vandemaelefelix/Project-4-Self-driving-car/lane_detection/images/image2.jpg

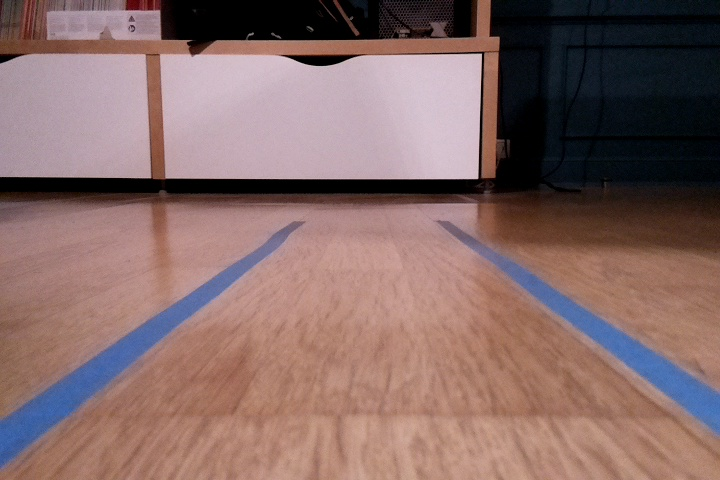
lane_detection/images/image2.jpg
