vandemaelefelix/Project-4-Self-driving-car/documentation/sources.pdf

[1] lanc1999Follow, “DC Motor Control With Raspberry Pi and L293D,” Instructables. [Online]. Available: https://www.instructables.com/id/DC-Motor-Control-With-Raspberry-Pi-and-L293D/. [Accessed: 23-Jan-2020].
[2] D. Tian, “DeepPiCar — Part 1: How to Build a Deep Learning, Self Driving Robotic Car on a Shoestring Budget,” Medium, 08-May-2019. [Online]. Available: https://towardsdatascience.com/deeppicar-part-1-102e03c83f2c. [Accessed: 23-Jan-2020].
[3] D. Tian, “DeepPiCar — Part 2: Pi Setup and PiCar Assembly,” Medium, 13-May-2019. [Online]. Available: https://towardsdatascience.com/deeppicar-part-2-8512be2133f3. [Accessed: 23-Jan-2020].
[4] “DeepPiCar — Part 4: Autonomous Lane Navigation via OpenCV.” [Online]. Available: https://towardsdatascience.com/deeppicar-part-4-lane-following-via-opencv-737dd9e47c96. [Accessed: 23-Jan-2020].
[5] D. Tian, “DeepPiCar — Part 5: Autonomous Lane Navigation via Deep Learning,” Medium, 17-May-2019. [Online]. Available: https://towardsdatascience.com/deeppicar-part-5-lane-following-via-deep-learningd93acdce6110. [Accessed: 23-Jan-2020].
[6] “End-to-End Deep Learning for Self-Driving Cars,” NVIDIA Developer Blog, 18-Aug-2016. [Online]. Available: https://devblogs.nvidia.com/deep-learning-self-driving-cars/. [Accessed: 23-Jan-2020].
[7] “How to write a simple python code to find the intersection point between two straight lines ?” [Online]. Available: https://www.science-emergence.com/Articles/How-to-write-a-simple-python-code-to-find-theintersection-point-between-two-straight-lines-/. [Accessed: 23-Jan-2020].
[8] H. S. Chadha, “Predicting Steering Angles using Deep Learning: Behaviour Cloning,” Medium, 19-Nov-2019. [Online]. Available: https://becominghuman.ai/behavioral-cloning-in-deep-learning-using-keras-3786f5914b72. [Accessed: 23-Jan-2020].
[9] “Raspberry Pi: Reading an analog potentiometer with the A/D converter MCP3008 and SPI | Knight of Pi.”
[Online]. Available: http://www.knight-of-pi.org/reading-an-analog-potentiometer-with-the-ad-convertermcp3008-and-spi/. [Accessed: 23-Jan-2020].
[10] S. Du, H. Guo, and A. Simpson, “Self-Driving Car Steering Angle Prediction Based on Image Recognition,” p. 9.
[11] “Teaching Cars To Drive Using Deep Learning — Steering Angle Prediction.” [Online]. Available: https://towardsdatascience.com/teaching-cars-to-drive-using-deep-learning-steering-angle-prediction-5773154608f2. [Accessed: 23-Jan-2020].
