vandemaelefelix/Project-4-Self-driving-car/documentation/schematics/scheme_servo_dc.png

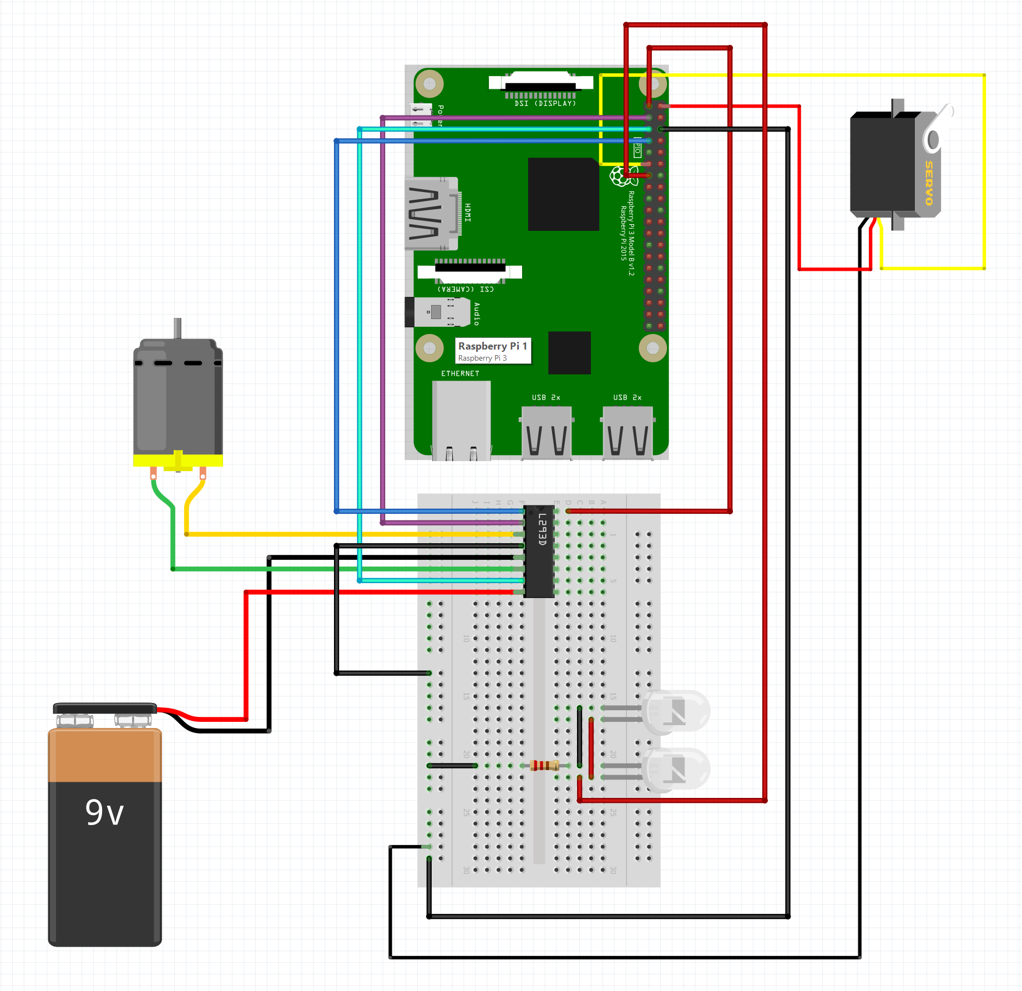
documentation/schematics/scheme_servo_dc.png
