vandemaelefelix/Project-4-Self-driving-car/documentation/schematics/scheme_servo_dc_pot.png

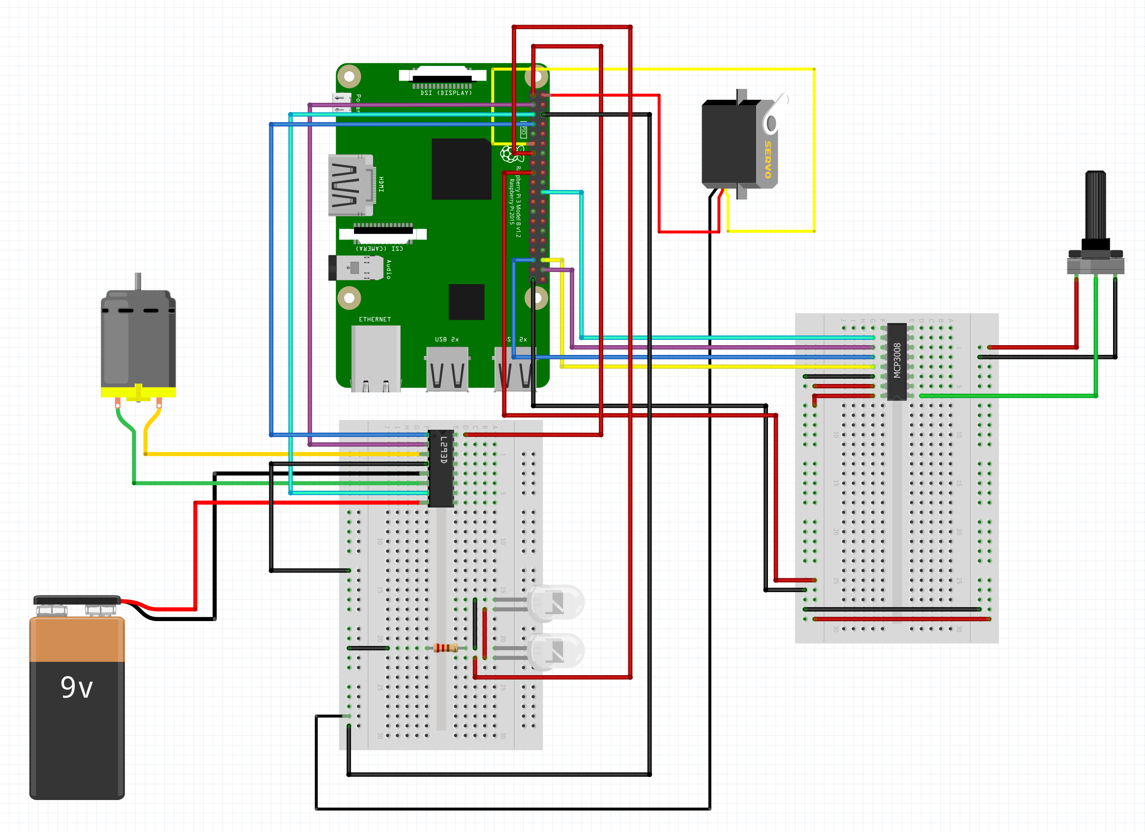
documentation/schematics/scheme_servo_dc_pot.png
