vandemaelefelix/Project-4-Self-driving-car/lane_detection/images/image1.jpg

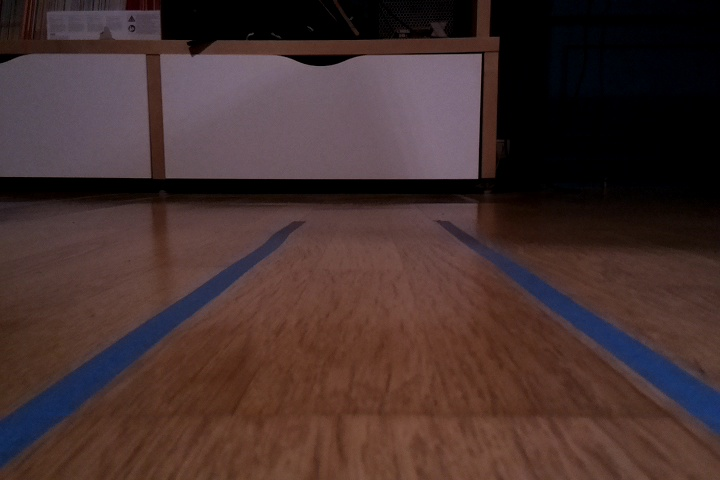
lane_detection/images/image1.jpg
