vandemaelefelix/Project-4-Self-driving-car/lane_detection/images/image3.jpg

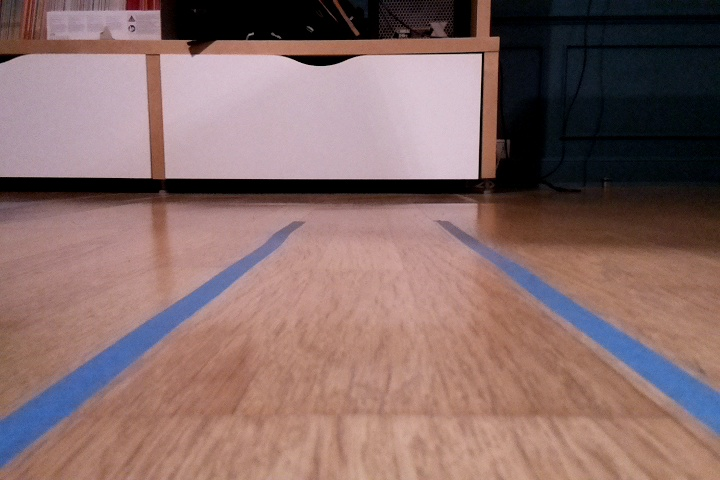
lane_detection/images/image3.jpg
