vandemaelefelix/Project-4-Self-driving-car/documentation/bill_of_materials.pdf

Product | URL | Price
RC-car | https://www.amazon.co.uk/Bentley-Remote-Control-Car-Rechargeable/dp/B07BNXBD2F | € 21,99
Rpi 3B+ | https://www.sossolutions.nl/raspberry-pi-3b | € 37,95
Micro SD-card 8GB | https://www.bol.com/nl/p/kingston-microsdhc-8gb-class- 4/9005000006528884/?bltgh=reCdCj4nB3s8yV- 6GpNAKg_qsrnub6KBSkCDbCbM7pBWQ_24.25.ProductTitle | € 6,59

Konig powebank
4400mah

https://www.codima.be/konig-powerbank-7800mah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

€ 19,95

Mini breadboard | https://nl.banggood.com/Mini-Breadboard-Protoboard-DIY-Kit-Universal-Transparent- Solderless-SYB-170-Breadboard-170Tie-points-Prototype-Boards-35X47MM-p- 1428688.html?gmcCountry=BE&currency=EUR&createTmp=1&utm_source=googleshopping&u tm_medium=cpc_bgcs&utm_content=xibei&utm_campaign=xibei-pla-beg-ele-0805- pc&ad_id=375732187904&gclid=Cj0KCQiApaXxBRDNARIsAGFdaB_gRp2sIj9vCmqJ6tPUd_Uk7 GWP1vKknkzu3Q8WVdKRe-7fO8CMp8YaAqT_EALw_wcB&cur_warehouse=CN

€ 1,25

Jumper wires | https://www.123-3d.nl/123-3D-Jumper-kabels-met-dupond-connector-vrouwelijk-naar- vrouwelijk-10-cm-40-stuks-i3160- t13138.html?mkwid=skftKAVPz_dc%7Cpcrid%7C301311133807%7Cpkw%7C%7Cpmt%7C%7C slid%7C%7Cprid%7CDDK00049_8719345009259_&pgrid=63047611354&ptaid=pla- 403002407950&gclid=Cj0KCQiApaXxBRDNARIsAGFdaB- nTjfa5FbADVJWd1XmFCEPxds_mg7ZA_Pu6pIBJqb_xSyjZtJU-WUaAhEyEALw_wcB

€ 3,60

Micro Servo -
MG90S High
Torque Metal Gear
https://www.sossolutions.nl/1143-micro-servo-mg90s-high-torque-metal-gear | € 14,95

Blue painters’ tape https://www.gamma.be/nl/assortiment/tesa-precision-outdoor-afplaktape-25-m-x-25-mm- blauw/p/B371150

€ 6,39

converter-adc-extern-pdip-16-; oo&utm_term=651456

MCP 3008 | https://www.conrad.be/p/microchip-technology-mcp3008-ip-data-acquisition-ic-analogdigital-
| 651456?t=1&utm_campaign=feed&utm_content=&utm_medium=vergelijkers&utm_source=kelk
L293D DC controller | https://www.digikey.be/product-detail/en/stmicro/L293D/497-2936-5- ND/634700?utm_adgroup=Integrated%20Circuits%20(ICs)&utm_source=google&utm_medium =cpc&utm_campaign=Shopping_STMicroelectronics_8090_Co- op&utm_term=&productid=634700&gclid=Cj0KCQiApaXxBRDNARIsAGFdaB_r_caSR5R_duL0E5 uFdLV4Q-yffSyqfDoIvD9UB98mUx602sEhoFgaAkz-EALw_wcB

€ 3,48

Picamera V2 | https://www.sossolutions.nl/raspberry-camera-module- v2?gclid=Cj0KCQiApaXxBRDNARIsAGFdaB_boshdNcc64wUlo82BspNsUbHk1- c3_5wi4lACSf8HoEd1ciQFOP0aAi9aEALw_wcB

€ 29,95

Potentiometer 10K https://www.conrad.be/p/potentiometer-service-rv16af-20-15k-b10k-draaipotmeter-1-slag- mono-0125-w-1-stuks- 1644142?t=1&utm_campaign=feed&utm_content=&utm_medium=vergelijkers&utm_source=kel koo&utm_term=1644142

€ 1,31

220 ohm resistor | https://www.reichelt.com/be/nl/metaalfilmweerstand-220-ohm-0207-0-6-w-1-k-o-sfcn2200t52- p237299.html?PROVID=2788&gclid=Cj0KCQiApaXxBRDNARIsAGFdaB8dphW9dVur9T4- FmlhkAjJp7MT6z2c-bQu4wm8o4AvLbmBDTLIzasaAlGXEALw_wcB&&r=1
| € 0,08
TOTAL | € 149,51
