vandemaelefelix/Project-4-Self-driving-car/(list of files, drawings)

Other design files:
documentation/schematics/schakeling.fzz
documentation/schematics/schakeling_pot.fzz
