vandemaelefelix/Project-4-Self-driving-car/documentation/manuals/installation_manual.pdf

1

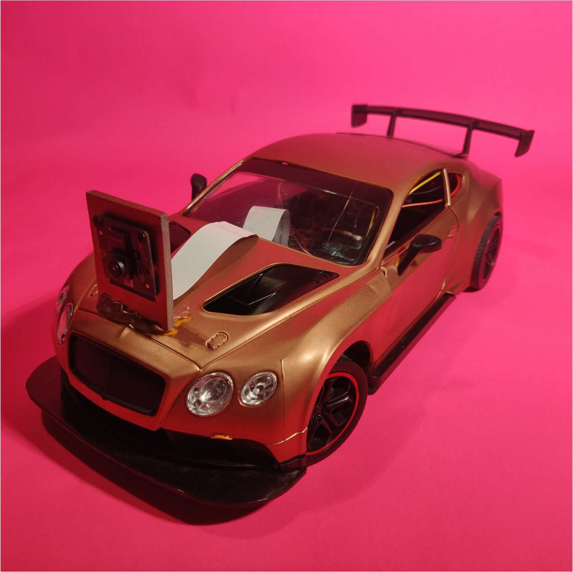
[picture p6: figure]

Self-Driving Car Using Deep Learning – Felix Vandemaele

# SELF DRIVING CAR

## By Felix Vandemaele

# Installation Manual

2
Self-Driving Car Using Deep Learning – Felix Vandemaele

# Contents

3
Self-Driving Car Using Deep Learning – Felix Vandemaele

# 1.Utilities:

## Materials

- RC-car
- Raspberry Pi 3B+
- Micro-SD card min. 8GB
- Micro-SD card reader
- Power bank min. output of 2A
- Mini breadboard x2
- Micro USB cable
- Jumper wires
- Servo motor
- Blue painters’ tape
- MCP 3008
- L293D DC controller
- Pi camera v2
- Some type of glue, I used a glue gun
- Screwdrivers
- PVC plate or cardboard could work as well
- Ethernet cable
- Potentiometer 10K
- Resistor 220Ω
- Clean Raspbian image
- Soldering iron

## Software

- Visual Studio Code (or other editor with remote connect function)
- Putty
- WinSCP
- Win32DiskImager

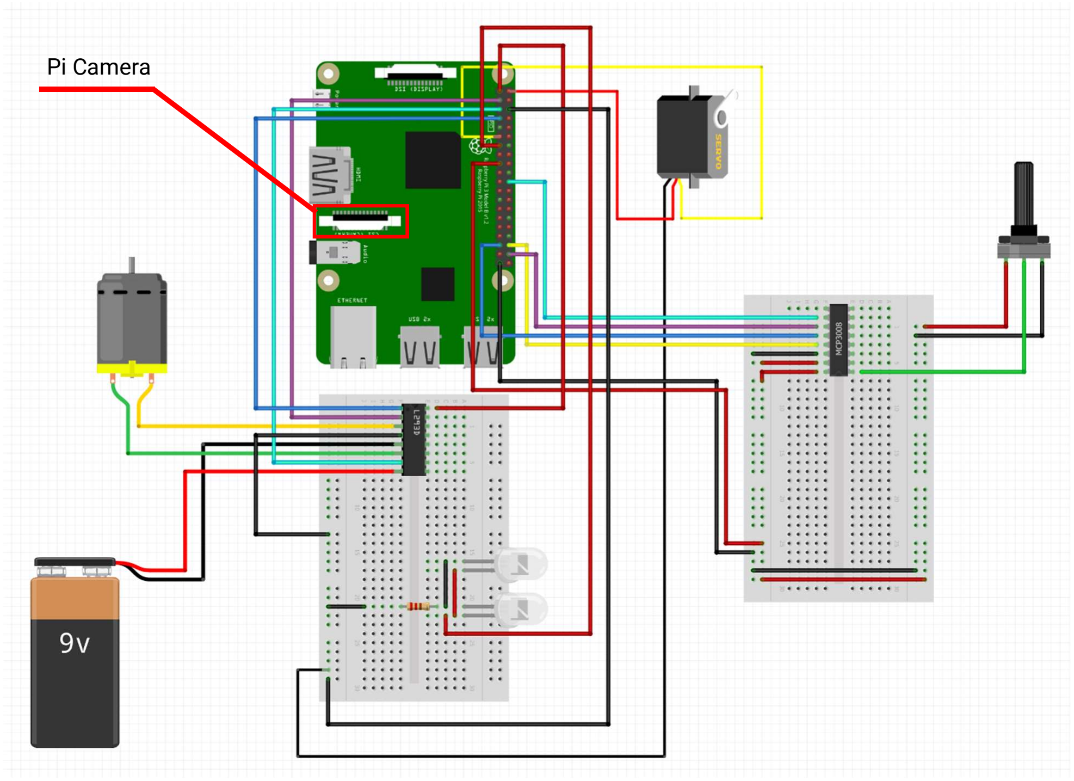
[picture p7: figure]
Pi Camera

4
Self-Driving Car Using Deep Learning – Felix Vandemaele

# 2.Setup Raspberry Pi

For this installation manual I assume that you have a clean install of Raspbian installed on your Raspberry Pi and that you have some basic knowledge of Linux commands and Raspberry Pi. If you don’t know how to install your Raspberry Pi, first complete the following document.

‘Preparing your Raspberry Pi V1.docx’

# 3.Hardware

Connect everything to your Raspberry Pi using the following scheme.

The car came with a DC motor for driving and another DC motor for steering. The problem of steering with a DC motor is that you can only steer left or right, but no angle in between. To steer multiple angles, you’ll need to replace the DC motor with a servo motor. The steering mechanism is different

5

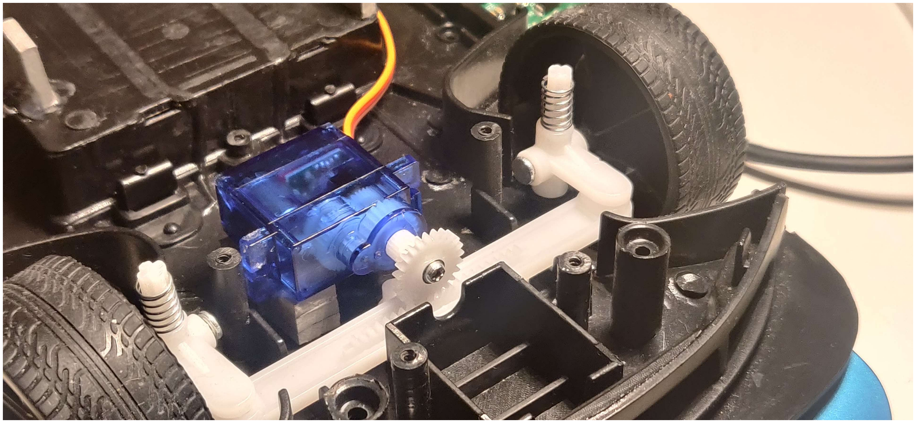
[picture p8: figure]
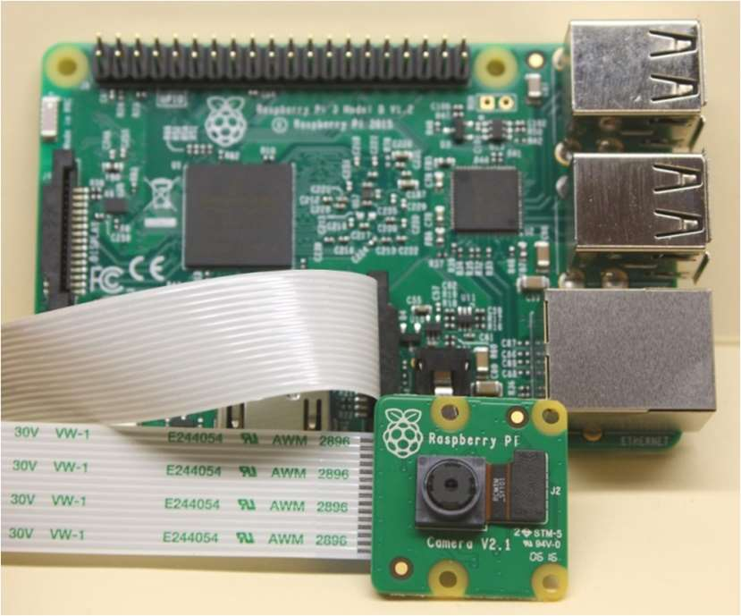
[picture p9: figure]

Self-Driving Car Using Deep Learning – Felix Vandemaele for every RC-car, so you’ll have to be creative to fit the servo. In the picture below you can see how I did it in my car.

Most RC cars use a standard DC motor to drive. Desolder the wires and connect them to the breadboard. The motor uses the regular 4.5V battery that came with the car. Most standard DC motors can handle up to 9V. This will give it more torque but will also generate some heat.

My RC-car already has headlights, so I connected them with the Raspberry Pi as well. I used a resistor, so they won’t burn out.

Connect the flat cable of the Pi Camera to the bracket on the Raspberry Pi. Just like on the picture below.

6

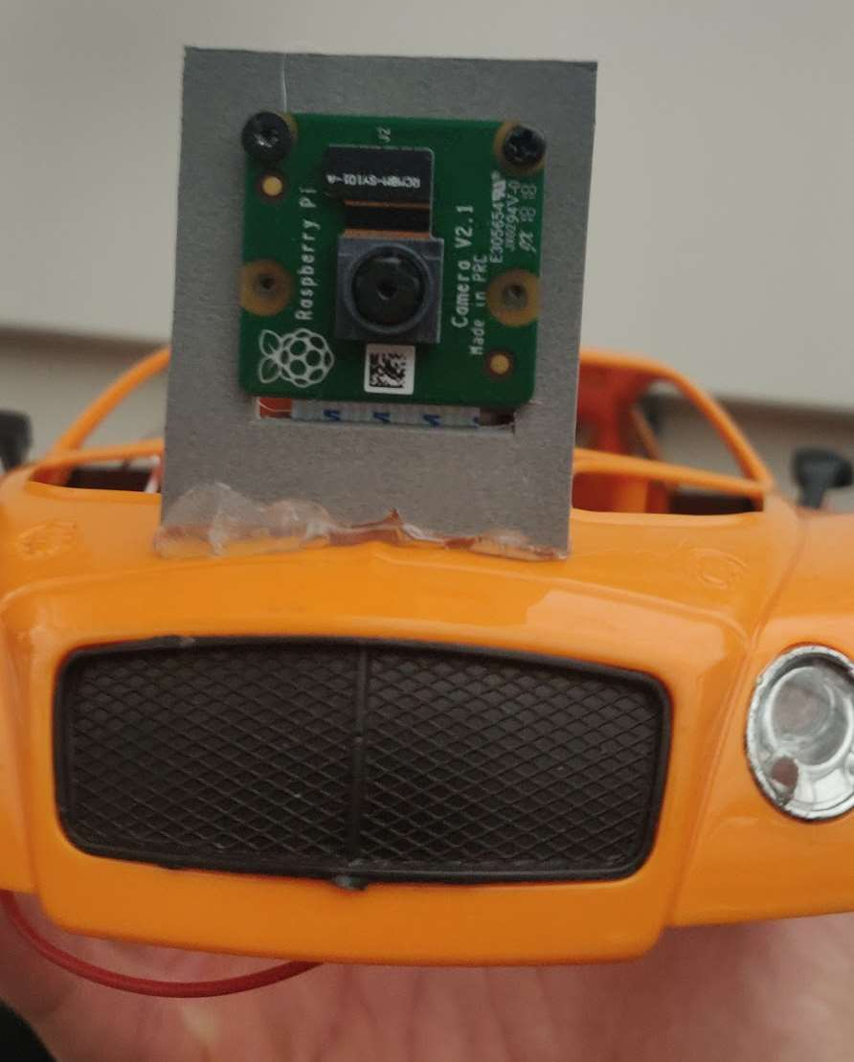
[picture p10: figure]
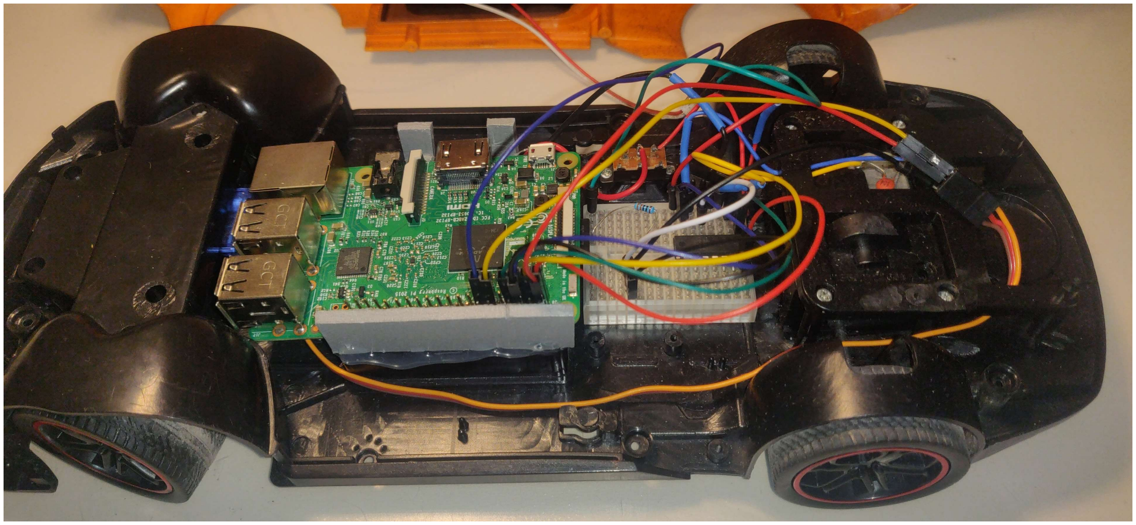
[picture p11: figure]

Self-Driving Car Using Deep Learning – Felix Vandemaele

I mounted the Pi Camera on a piece of PVC board and hot glued it to the front of the car.

Make sure it’s very sturdy, because you don’t want the camera angle to change at any time. This could affect the performance of your car by a lot!!

When everything is connected you can stuff it all inside the car. I used a hot glue gun and pieces of PVC board to make sure everything is secured (I think cardboard could do the job as well, but PVC board is a bit sturdier).

7

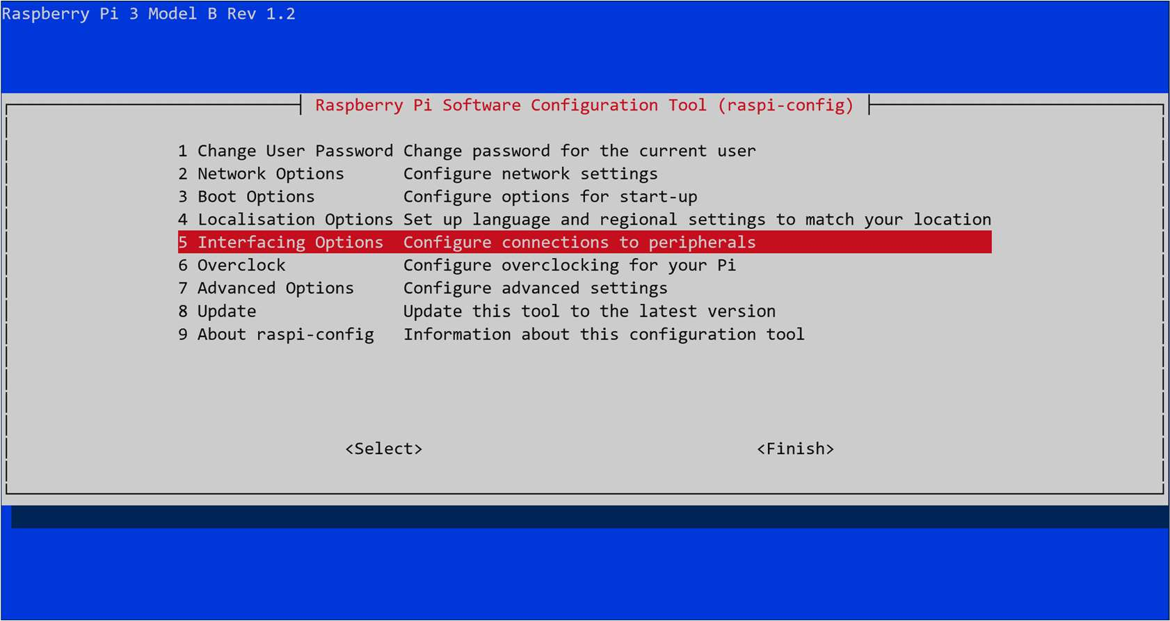
[picture p12: figure]

Self-Driving Car Using Deep Learning – Felix Vandemaele

# 4.Enabling Hardware

To use the Pi Camera and the potentiometer, you must enable some settings.

sudo raspi-config

Under ‘Interfacing Options’ enable ‘Camera’ and ‘SPI’.

Select ‘Finish’ and reboot the pi.

# 5.Installing Code

Clone the code from github into the user folder.

git clone https://github.com/vandemaelefelix/Project-4.git

# 6.Installing Python Packages

You can try to install the newest version of each package, but these versions worked for me so I advise you to use them.

## Update Raspberry Pi

Begin with updating your Raspberry Pi so you have all the latest packages available.

8
Self-Driving Car Using Deep Learning – Felix Vandemaele

sudo apt update

sudo apt upgrade

## Installing OpenCV

!! The latest version of OpenCV doesn’t work on Raspberry Pi so you’ll have to install an older version !!

pip3 install opencv-python==3.4.6.27

pip3 install opencv-contrib-python==3.4.3.18

## Installing TensorFlow

!! The latest version of Tensorflow doesn’t work on Raspberry Pi so you’ll again have to install an older version !!

pip3 install tensorflow==1.14.0

## Install PiCamera

pip3 install picamera==1.13

## Install Numpy

pip3 install numpy==1.16.2

9

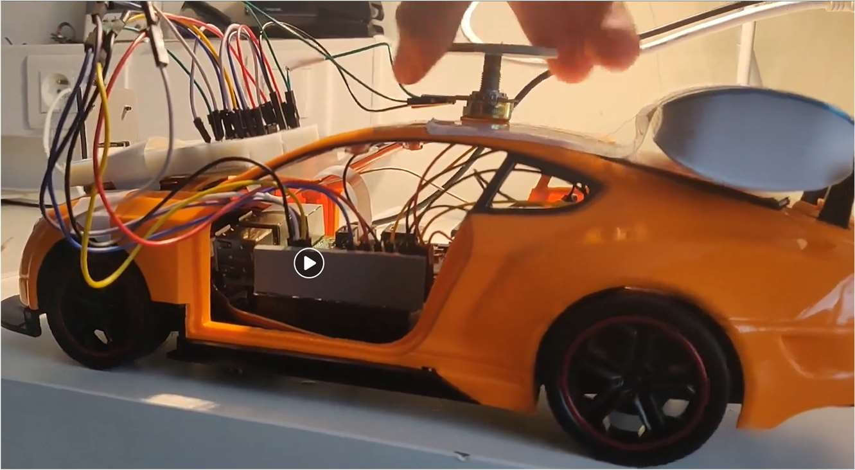
[picture p13: figure]
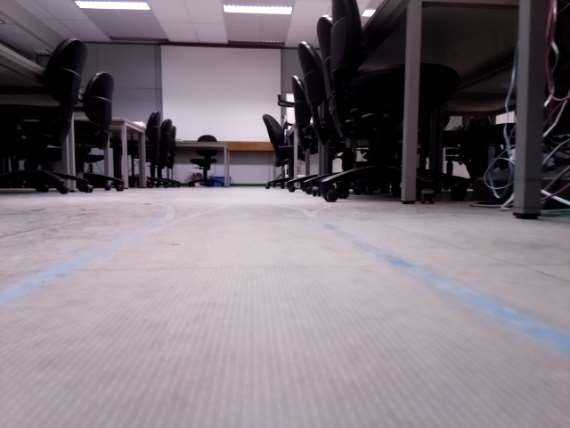
[picture p14: figure]

Self-Driving Car Using Deep Learning – Felix Vandemaele

# 7.Capturing Data

There are several ways to collect data. I mounted a potentiometer on my car to drive it manually. While driving, the camera takes pictures (size of pictures is 640 x 480) and saves them to a data folder.

Depending on how robust you want the model to be, you can collect more and more data. I have about 3000 pictures. They’re all taken on one track so it could work on other tracks as well, but not as good as on the original.

To start the ‘capture_data.py’ script, type:

cd code/
python3 capture_data.py -p

When you have enough images, you can transfer them to your computer to train the model.

10
Self-Driving Car Using Deep Learning – Felix Vandemaele

# 8.Training Model

We’ll train the model on our PC because Raspberry Pi isn’t strong enough to handle such heavy tasks.

Before training you’ll have to install several pip packages.

## Installing Jupyter Lab

pip3 install jupyterlab

## Installing Tensorflow

pip3 install tensorflow==2.1.0

## Installing Keras

pip3 install Keras==2.3.1

In the GitHub repository under ‘neural_network’ there is a Jupyter Notebook with the code to train your model.

Inside the Jupyter Notebook, there is a path that refers to a data folder. Edit this path so it leads to the data you just collected.

11

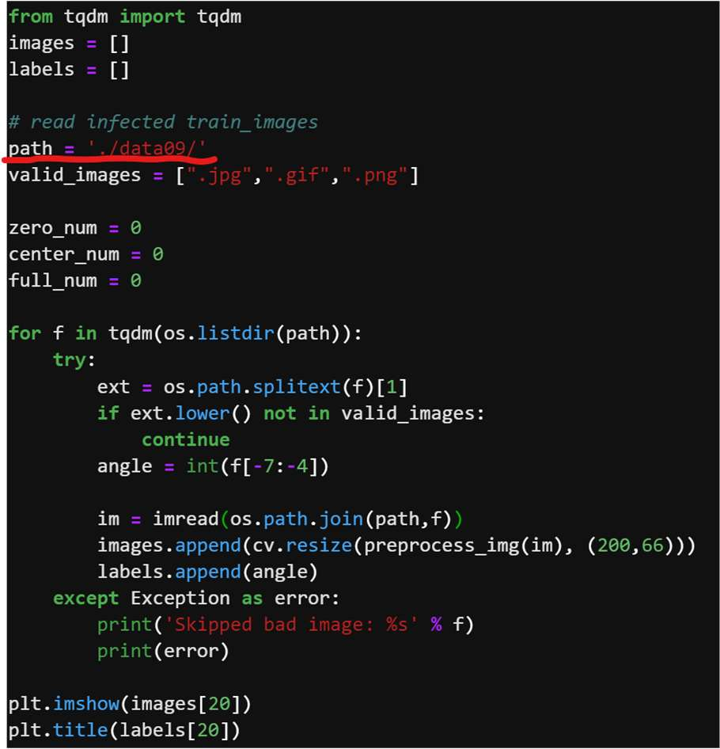
[picture p15: figure]
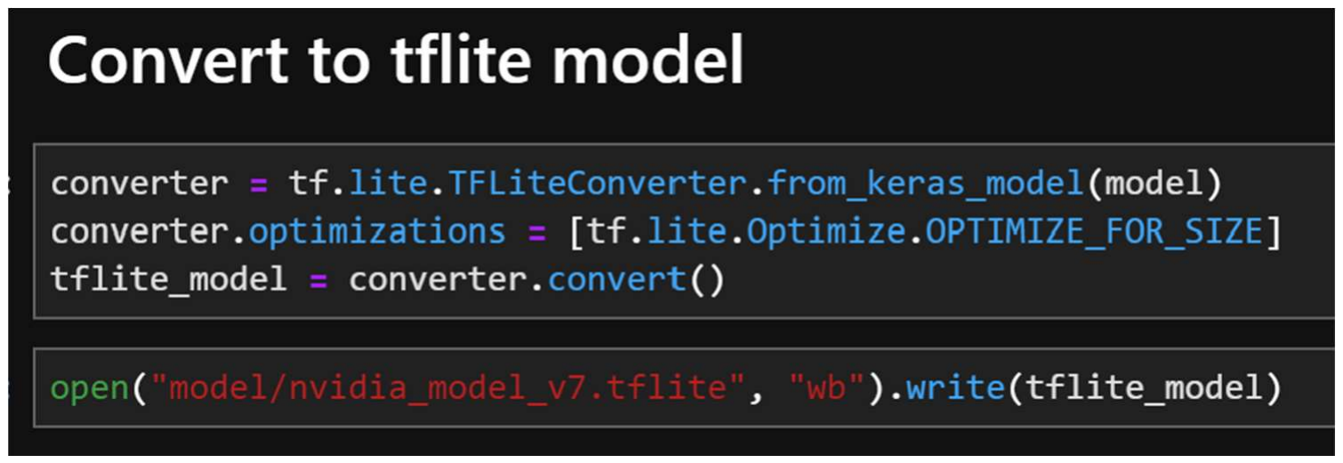
[picture p16: figure]

Self-Driving Car Using Deep Learning – Felix Vandemaele

After training you can save the model as tflite file.

When the model is converted, you can upload it to the Raspberry Pi using WinSCP.

# 9.Start Driving

You’re all done now. The Raspberry Pi is completely setup. Follow the instructions in the user manual to start the car.
