vandemaelefelix/Project-4-Self-driving-car/(commit log)

2020-01-23 Added code to run on Raspberry Pi
2020-01-23 Adding almost everything
    [schakeling.fzz, schakeling_pot.fzz]
